Shubhjaiswal408/sleeplamp-mmwave-sleep-tracker/PCB Design/mmwave lamp schematics.pdf

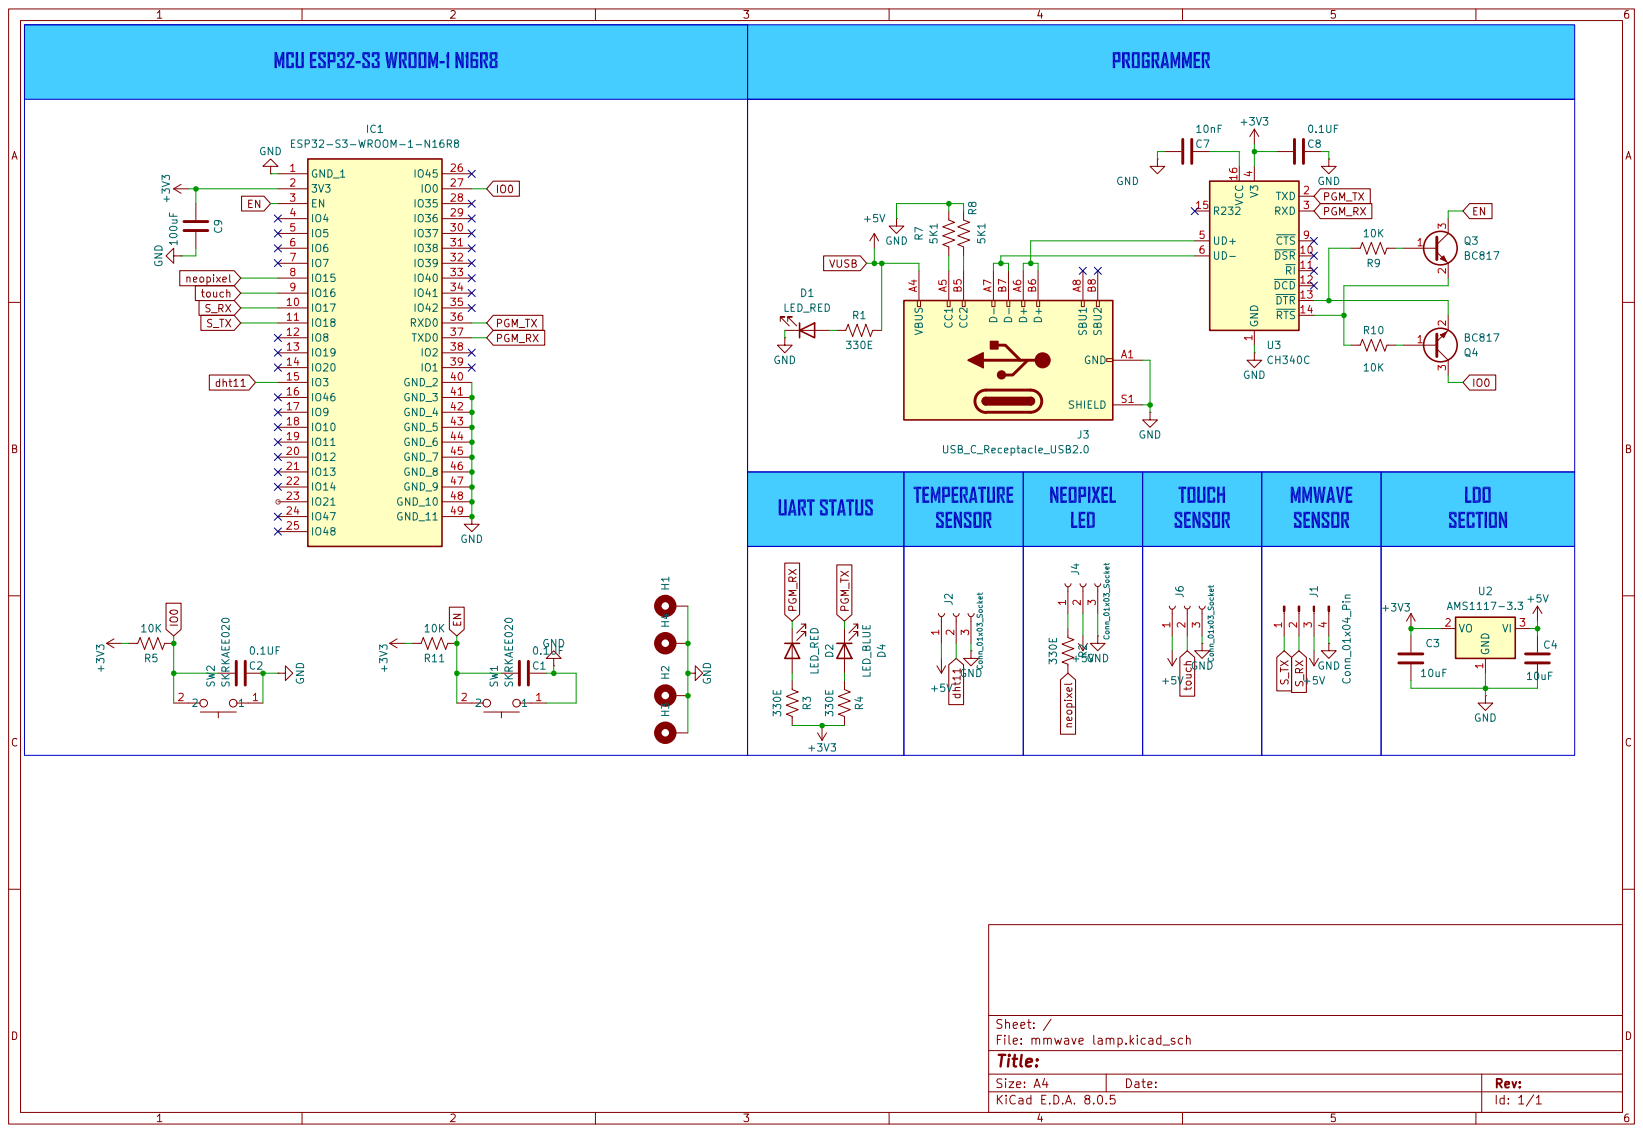
[picture p1: page 1]
