Shubhjaiswal408/sleeplamp-mmwave-sleep-tracker/(commit log)

2026-07-21 Board pin remap, radar RX/TX swap, single-tap lamp cycle, status colours, hypnogram calendar
    - config.h: NeoPixel->IO15, Touch->IO16, DHT11->IO3; radar RADAR_RX/TX swapped to 17/18 (this board's wiring); touch debounce 250ms
    - Touch.ino: single-tap brightness cycle Auto->Dim->Med->Max->Off (one button reaches everything)
    - Light.ino: coherent status-colour state machine (white idle / green up / blue in-bed / off asleep; red HR-lock pulse kept)
    - page_body.h + page_js.h: hypnogram calendar date-picker to jump to any saved night
    - Matter.ino + Settings.ino: feedback-loop + colour-corruption guards (Matter still disabled)
    - Store.ino + types.h + sleeplamp.ino: per-night timeline storage + /api/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
    [Light.ino, Matter.ino, Settings.ino, Store.ino, Touch.ino, c1001_s3_test.ino, config.h]
2026-07-22 README: bring it up to date and give it a real voice
    - Correct the wiring to the current pin map (radar RX/TX 17/18, NeoPixel 15, touch 16,
    DHT 3) and add the TX/RX cross-over tip that cost me an evening
    - Touch is now a one-tap cycle (Auto->Dim->Med->Max->Off); lamp documents the real
    status-colour scheme (white/red-pulse/green/blue/off)
    - Be honest about Matter: built, then shelved over an mDNS clash (was claiming it works)
    - Hypnogram now mentions the calendar / date browsing
    - Add a "Build log - things that bit me" section with the actual debugging war stories
    - Update board settings (Matter off, 16 MB flash, huge_app rationale)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
2026-07-22 README: mark project v1-complete (custom PCB + 3D-printed enclosure)
    Project is finished hardware now, not a breadboard. Replaced the Roadmap/wishlist with a
    "Status - v1 complete" section: PCB and enclosure done, dropped the unshipped future items.
